AlexanderMandera/CH32V003-USB-DevBoard/Schematic.pdf

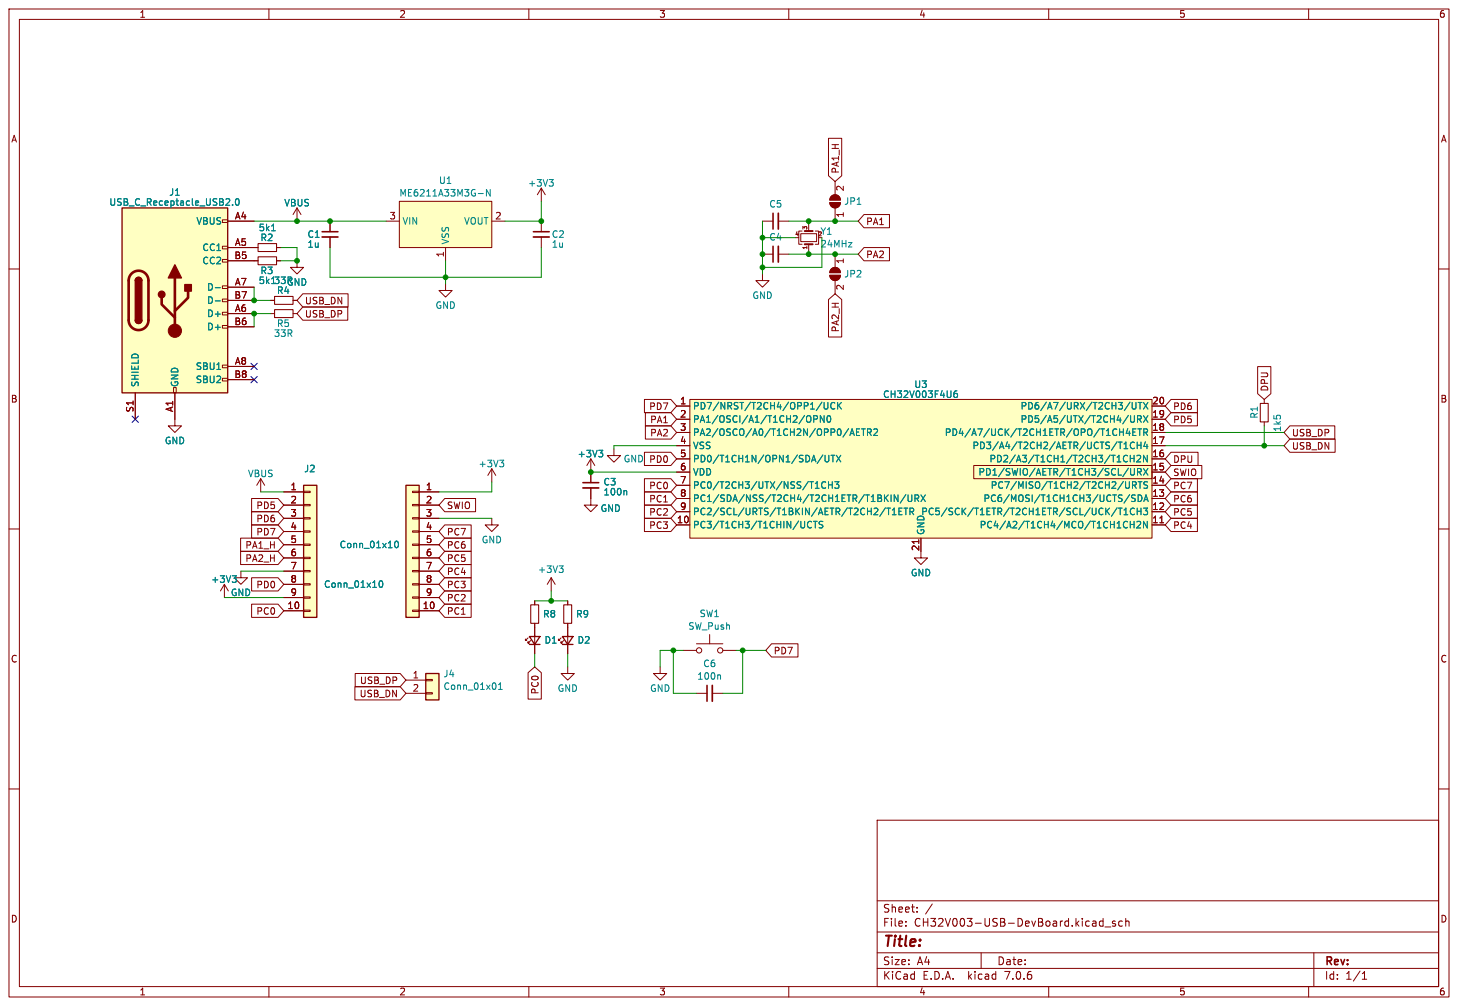
[picture p3: page 1]

1 2 JP1 GND GND A1 VBUS A4 CC1 A5 D+ A6 D- A7 SBU1 A8 CC2 B5 D+ B6 D- B7 SBU2 B8 SHIELD S1
