AlexanderMandera/CH32V003-USB-DevBoard/(commit log)

2023-07-17 Change clearances, add lines as placeholder for jumper
    [CH32V003-USB-DevBoard.kicad_pcb, CH32V003-USB-DevBoard.kicad_sch]
2023-07-17 Fix 3v3 trace
    [CH32V003-USB-DevBoard.kicad_pcb]
2023-07-18 New routing, thank you πter; small tweaks
    [CH32V003-USB-DevBoard.kicad_pcb, CH32V003-USB-DevBoard.kicad_sch]
2023-07-18 Move USB-C connector up
    [CH32V003-USB-DevBoard.kicad_pcb, CH32V003-USB-DevBoard.kicad_sch]
2023-07-19 Add solder jumper, minor tweaks
    [CH32V003-USB-DevBoard.kicad_pcb, CH32V003-USB-DevBoard.kicad_sch]
2023-07-19 Move USB connector up
    [CH32V003-USB-DevBoard.kicad_pcb]
2023-07-19 Fix via size
    [CH32V003-USB-DevBoard.kicad_pcb]
2023-10-22 Update schematic and PCB files
    [CH32V003-USB-DevBoard.kicad_pcb, CH32V003-USB-DevBoard.kicad_sch]
